OLIMEX/SOM204/SOM204-EVB/SOM204-EVB_Rev_C2.pdf

+

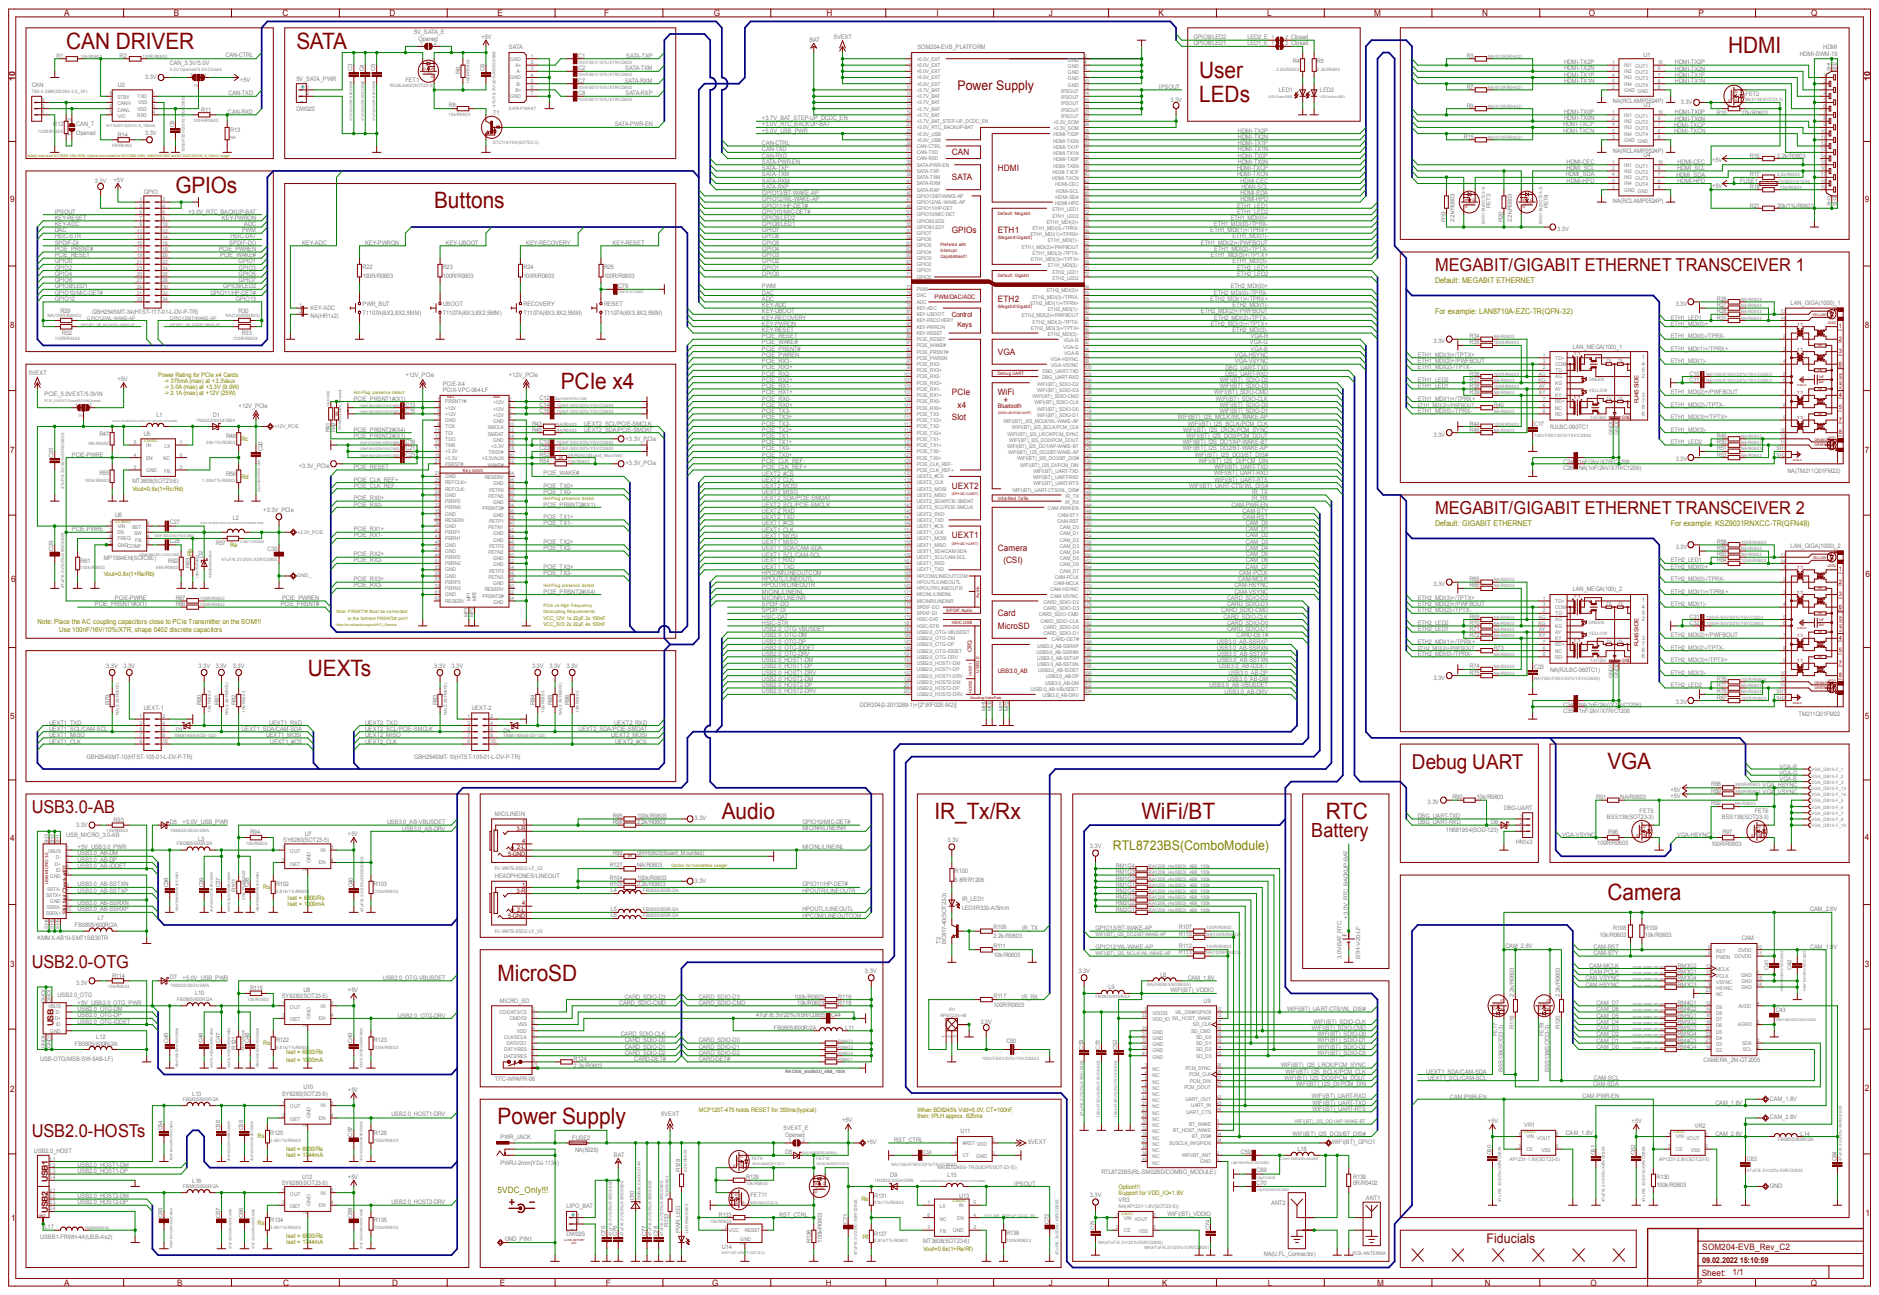
[picture p1: page 1]

Initially was used: MCP2551-I/SN(SO8). Options were added for MCP2562-E/SN, SN65HVD230D and SIT1042T/3(SOIC-8_150mil) usage!

SATA-PWR-EN 35
SATA-TXM 39 SATA-TXP 37

SATA-RXM 41
SATA-RXP 43
GPIO0 71 GPIO1 69 GPIO2 67 GPIO3 65 GPIO4 63 GPIO5 61 GPIO6 59 GPIO7 57 GPIO8/LED1 55 GPIO9/LED2 53 GPIO10/MIC-DET 51 GPIO11/HP-DET 49 GPIO12/WL-WAKE-AP 47 GPIO13/BT-WAKE-AP 45

MEGABIT/GIGABIT ETHERNET TRANSCEIVER 1

For example: LAN8710A-EZC-TR(QFN-32)

WIFI(BT)_I2S_MCLK/WL-WAKE-AP

WIFI(BT)_I2S_DO2/BT-WAKE-AP

Power Rating for PCIe x4 Cards:
-> 375mA (max) at +3.3Vaux
-> 3.0A (max) at +3.3V (9.9W)
-> 2.1A (max) at +12V (25W)

Hot-Plug presence detect

(SDIO+I2S/PCM+UART)
WIFI(BT)_I2S_MCLK/WL-WAKE-AP 116
WIFI(BT)_I2S_BCLK/PCM_CLK 118

WIFI(BT)_I2S_BCLK/PCM_CLK
WIFI(BT)_I2S_LRCK/PCM_SYNC
WIFI(BT)_I2S_DO0/PCM_DOUT

WIFI(BT)_I2S_DO0/PCM_DOUT 122
WIFI(BT)_I2S_DO1/AP-WAKE-BT 124
WIFI(BT)_I2S_DO2/BT-WAKE-AP 126
WIFI(BT)_I2S_DO3/BT_DIS# 128

WIFI(BT)_I2S_DO1/AP-WAKE-BT
WIFI(BT)_I2S_DO3/BT_DIS#
WIFI(BT)_I2S_DI/PCM_DIN
WIFI(BT)_UART-TXD
WIFI(BT)_UART-RXD

UEXT2_RXD 145 UEXT2_SCL/PCIE-SMCLK 143 UEXT2_SDA/PCIE-SMDAT 141

Infra-Red Tx/Rx

MEGABIT/GIGABIT ETHERNET TRANSCEIVER 2

UEXT1_RXD 161 UEXT1_SCL/CAM-SCL 159 UEXT1_SDA/CAM-SDA 157

CAM_D6 162
CAM_D7 164
CAM-HSYNC 170 CAM-MCLK 168 CAM-PCLK 166

PCIE_PRSNT2#(X4)

Note: PRSNT1# Must be connected
to the farthest PRSNT2# pin!!!

SPDIF-DI 177 SPDIF-DO 175

Note: Place the AC coupling capacitors close to PCIe Transmitter on the SOM!!!

Use 100nF/16V/10%/X7R, shape 0402 discrete capacitors

https://en.wikipedia.org/wiki/PCI_Express
UEXTs

Op tion for handsfree usage!

GPIO13/BT-WAKE-AP
GPIO12/WL-WAKE-AP

USB-OTG(MSB-SW-5AB-LF)

MCP120T-475 holds RESET for 350ms(typical)
