OLIMEX/SOM204/A20-SOM204/A20-SOM204_Rev_C1.pdf

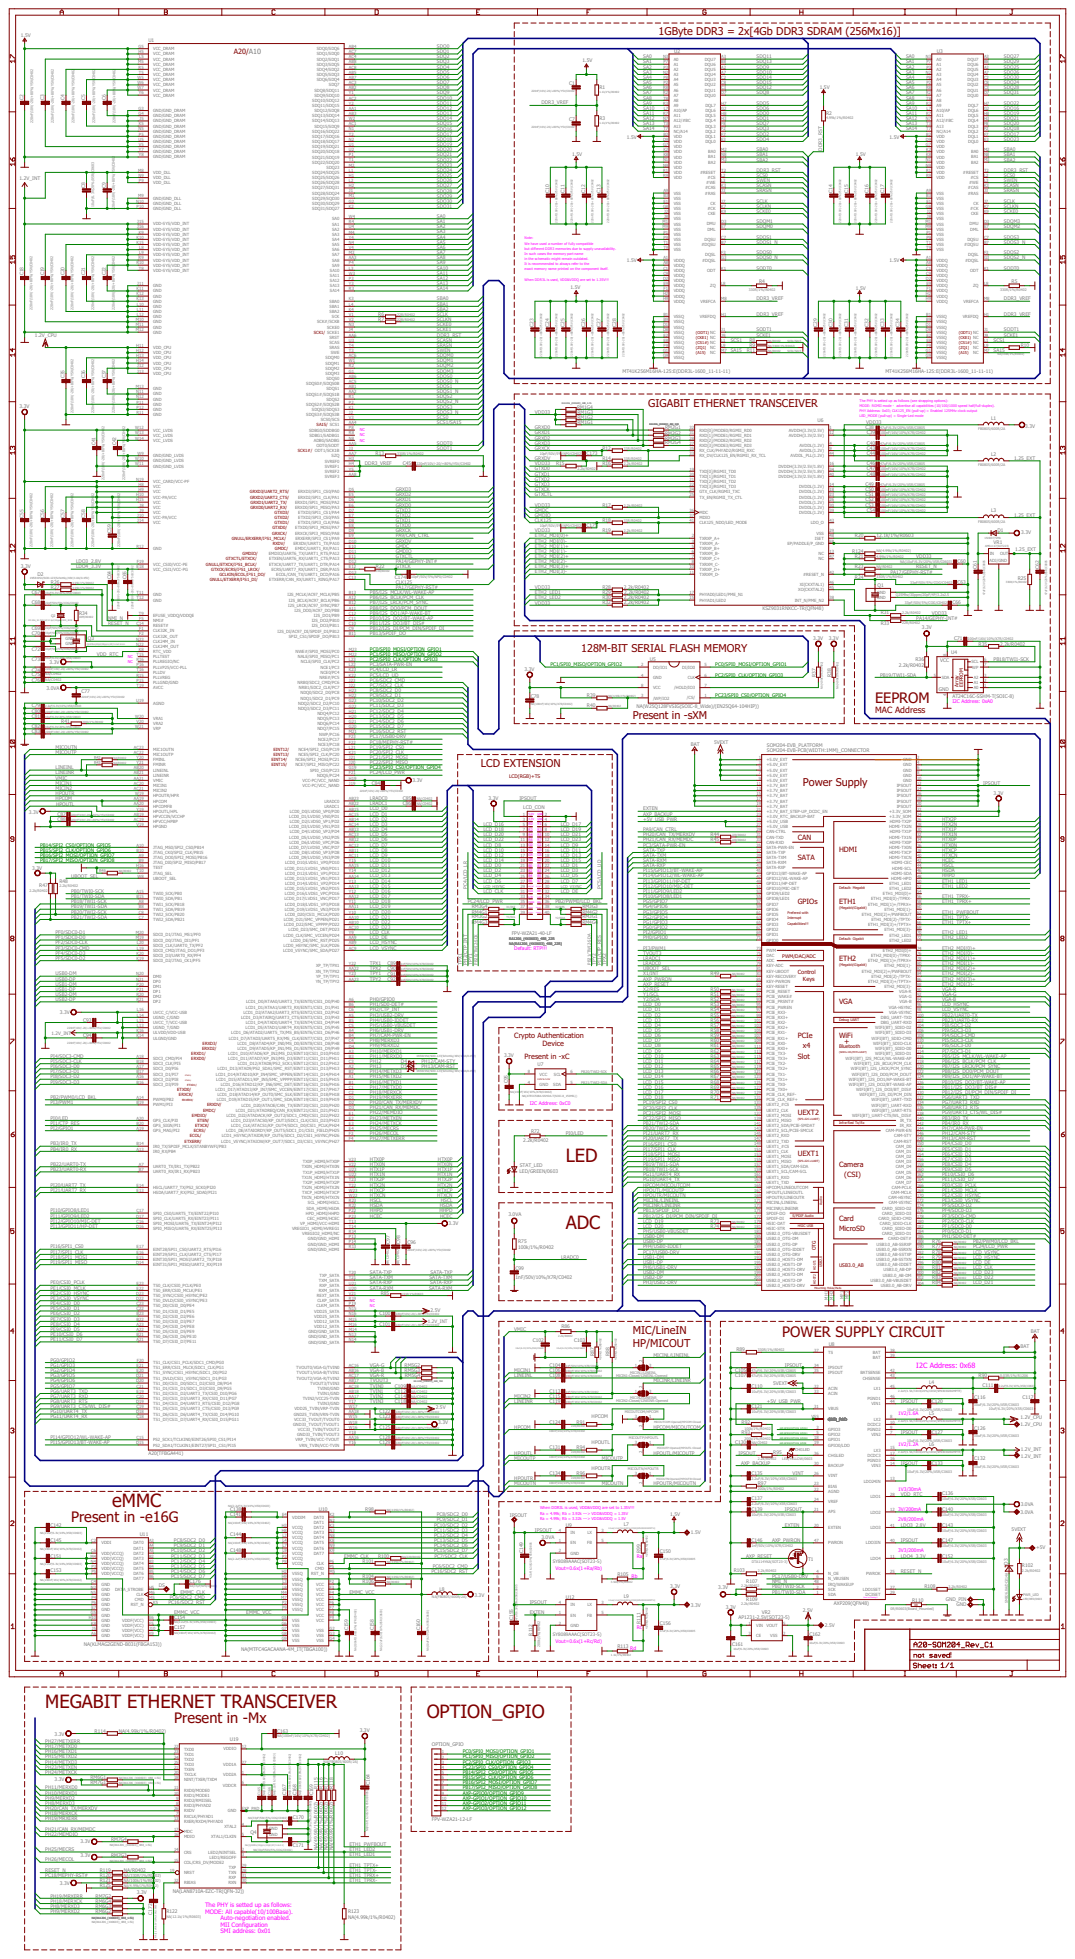
[picture p2: page 1]

74 DAC
78 KEY-ADC

1N5819S4/SOD-123(Schottky/40V/1.0A/0.45V)
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
