OLIMEX/SOM204/A20-SOM204/A20-SOM204_Rev_B1_1Gs16Me16G-MC.pdf

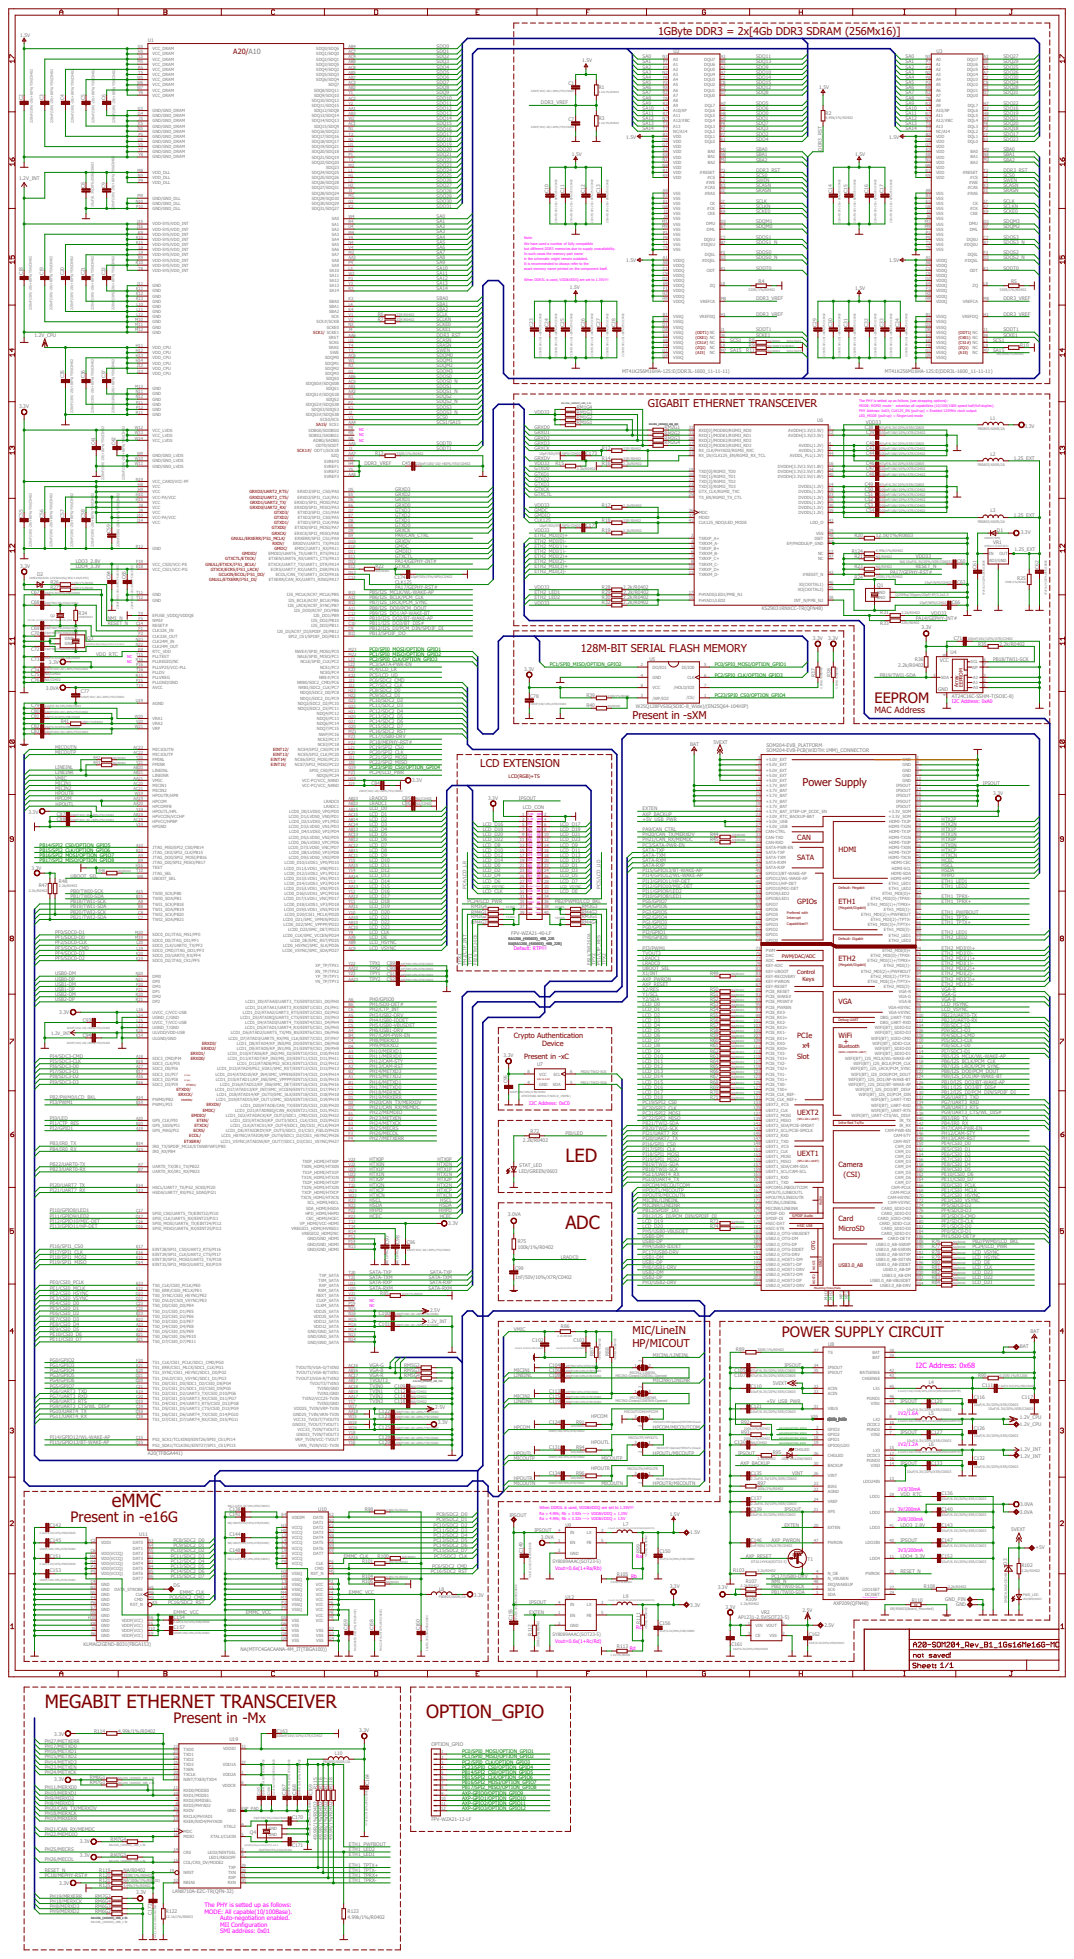
[picture p4: page 1]

74 DAC
78 KEY-ADC
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
