OLIMEX/SOM204/SOM204-EVB/SOM204-EVB_Rev_B1.pdf

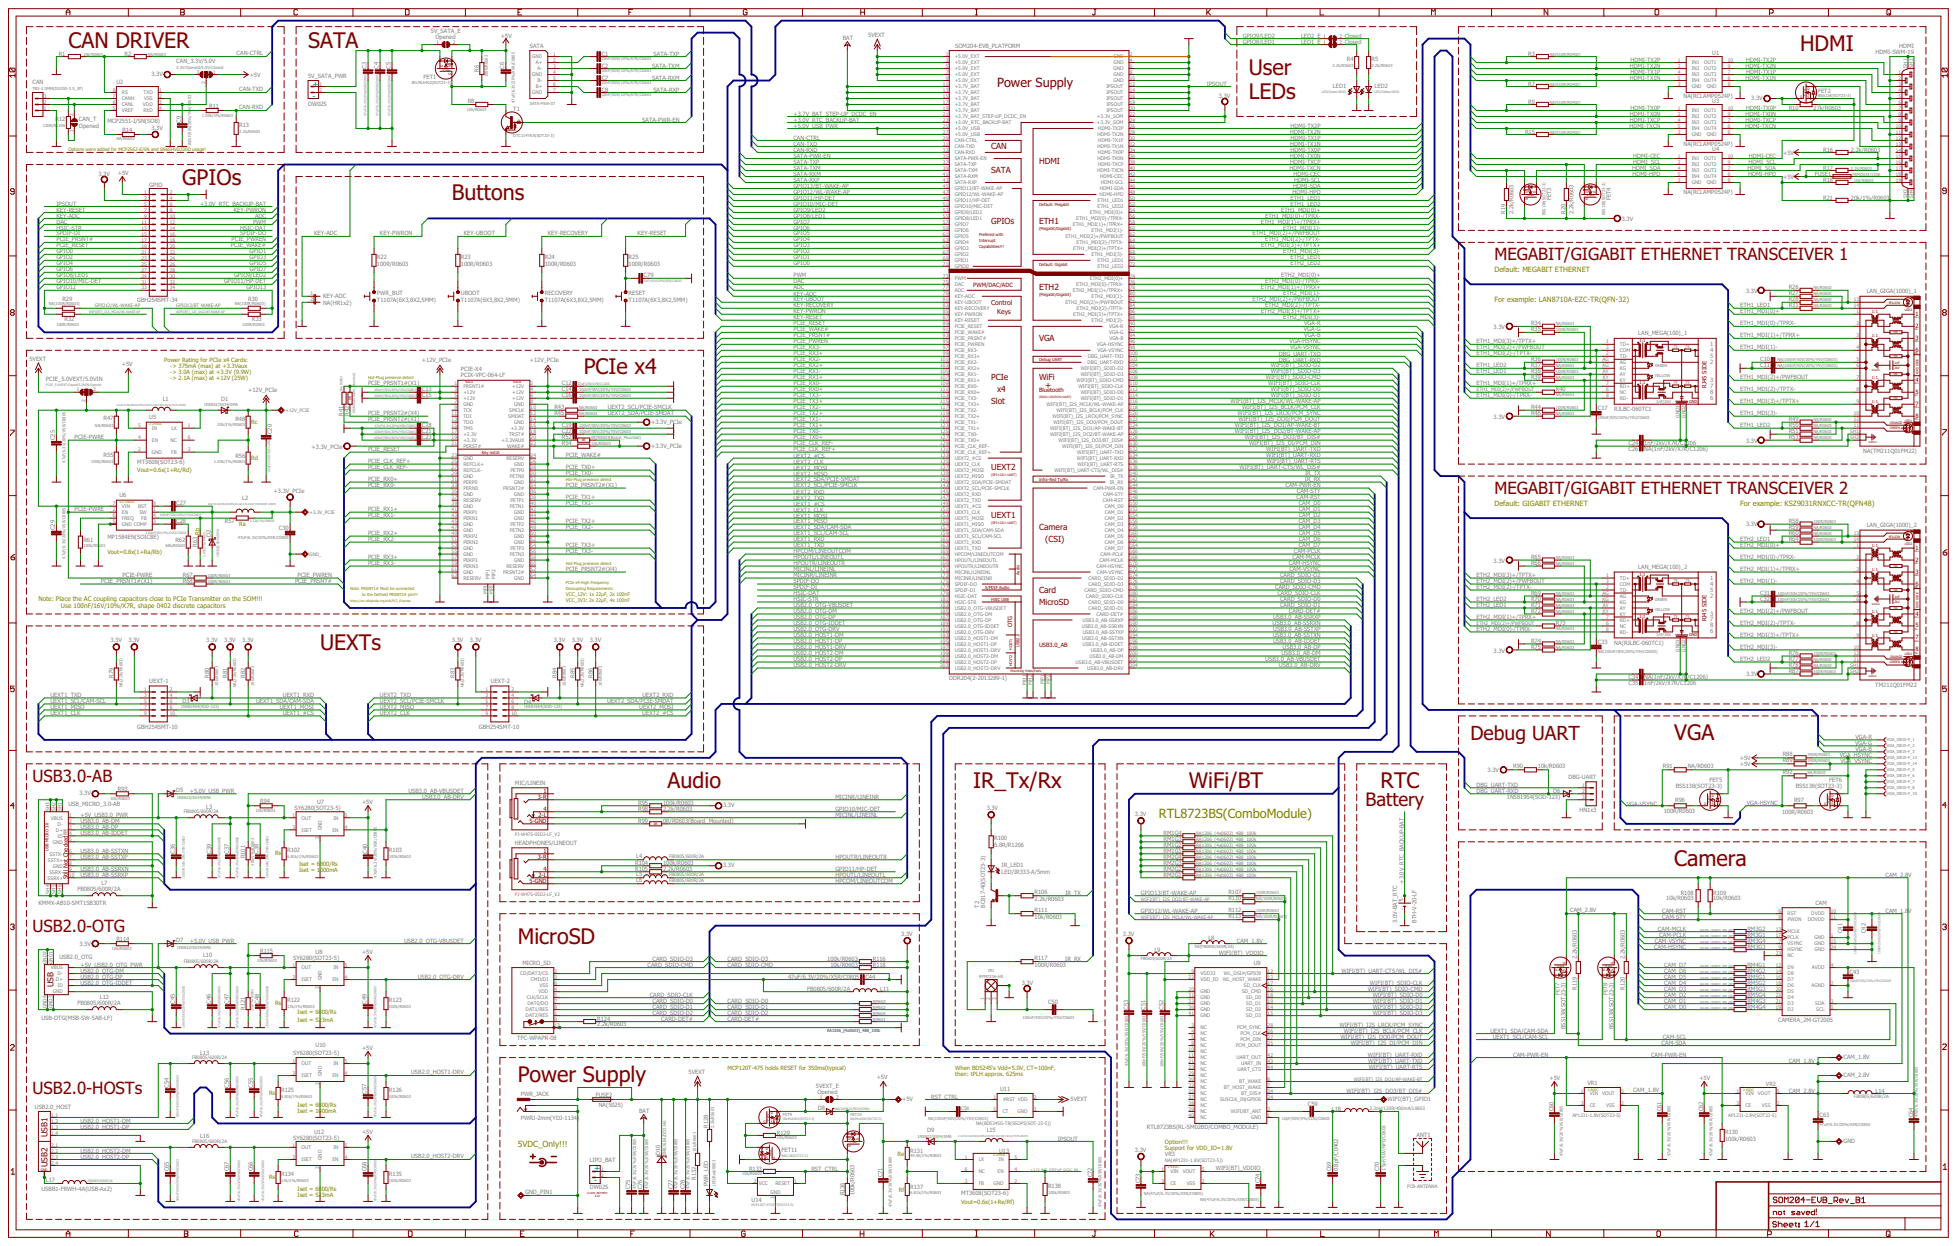
[picture p5: page 1]

Options were added for MCP2562-E/SN and SN65HVD230D usage!

Prefered with Capabilities!!! Interrupt

MEGABIT/GIGABIT ETHERNET TRANSCEIVER 1

For example: LAN8710A-EZC-TR(QFN-32)

WIFI(BT)_I2S_MCLK/WL-WAKE-AP

WIFI(BT)_I2S_DO2/BT-WAKE-AP

Hot-Plug presence detect Power Rating for PCIe x4 Cards: -> 3.0A (max) at +3.3V (9.9W)
-> 375mA (max) at +3.3Vaux

Debug UART WiFi Bluetooth +

WIFI(BT)_I2S_BCLK/PCM_CLK
WIFI(BT)_I2S_LRCK/PCM_SYNC

WIFI(BT)_I2S_DO0/PCM_DOUT
WIFI(BT)_I2S_DO1/AP-WAKE-BT
WIFI(BT)_I2S_DO3/BT_DIS#
WIFI(BT)_I2S_DI/PCM_DIN

ETH1_LED2

Infra-Red Tx/Rx

MEGABIT/GIGABIT ETHERNET TRANSCEIVER 2

Hot-Plug presence detect
PCIE_PRSNT2#(X4)

Note: PRSNT1# Must be connected
to the farthest PRSNT2# pin!!! https://en.wikipedia.org/wiki/PCI_Express

PCIe x4 High Frequency VCC_12V: 1x 22µF, 2x 100nF VCC_3V3: 2x 22µF, 4x 100nF Decoupling Requirements:

S/PDIF Audio HSIC USB

Note: Place the AC coupling capacitors close to PCIe Transmitter on the SOM!!!

Use 100nF/16V/10%/X7R, shape 0402 discrete capacitors

USB MICRO 3.0 Still Not Checked!!!

GPIO13/BT-WAKE-AP

GPIO12/WL-WAKE-AP

USB-OTG(MSB-SW-5AB-LF)

CAM-SCL CAM-SDA

When BD5245's Vdd=5.0V, CT=100nF, then: tPLH approx. 625ms MCP120T-475 holds RESET for 350ms(typical)
