OLIMEX/SOM204/A20-SOM204/A20-SOM204_Rev_C_1Gs16Me16G-MC.pdf

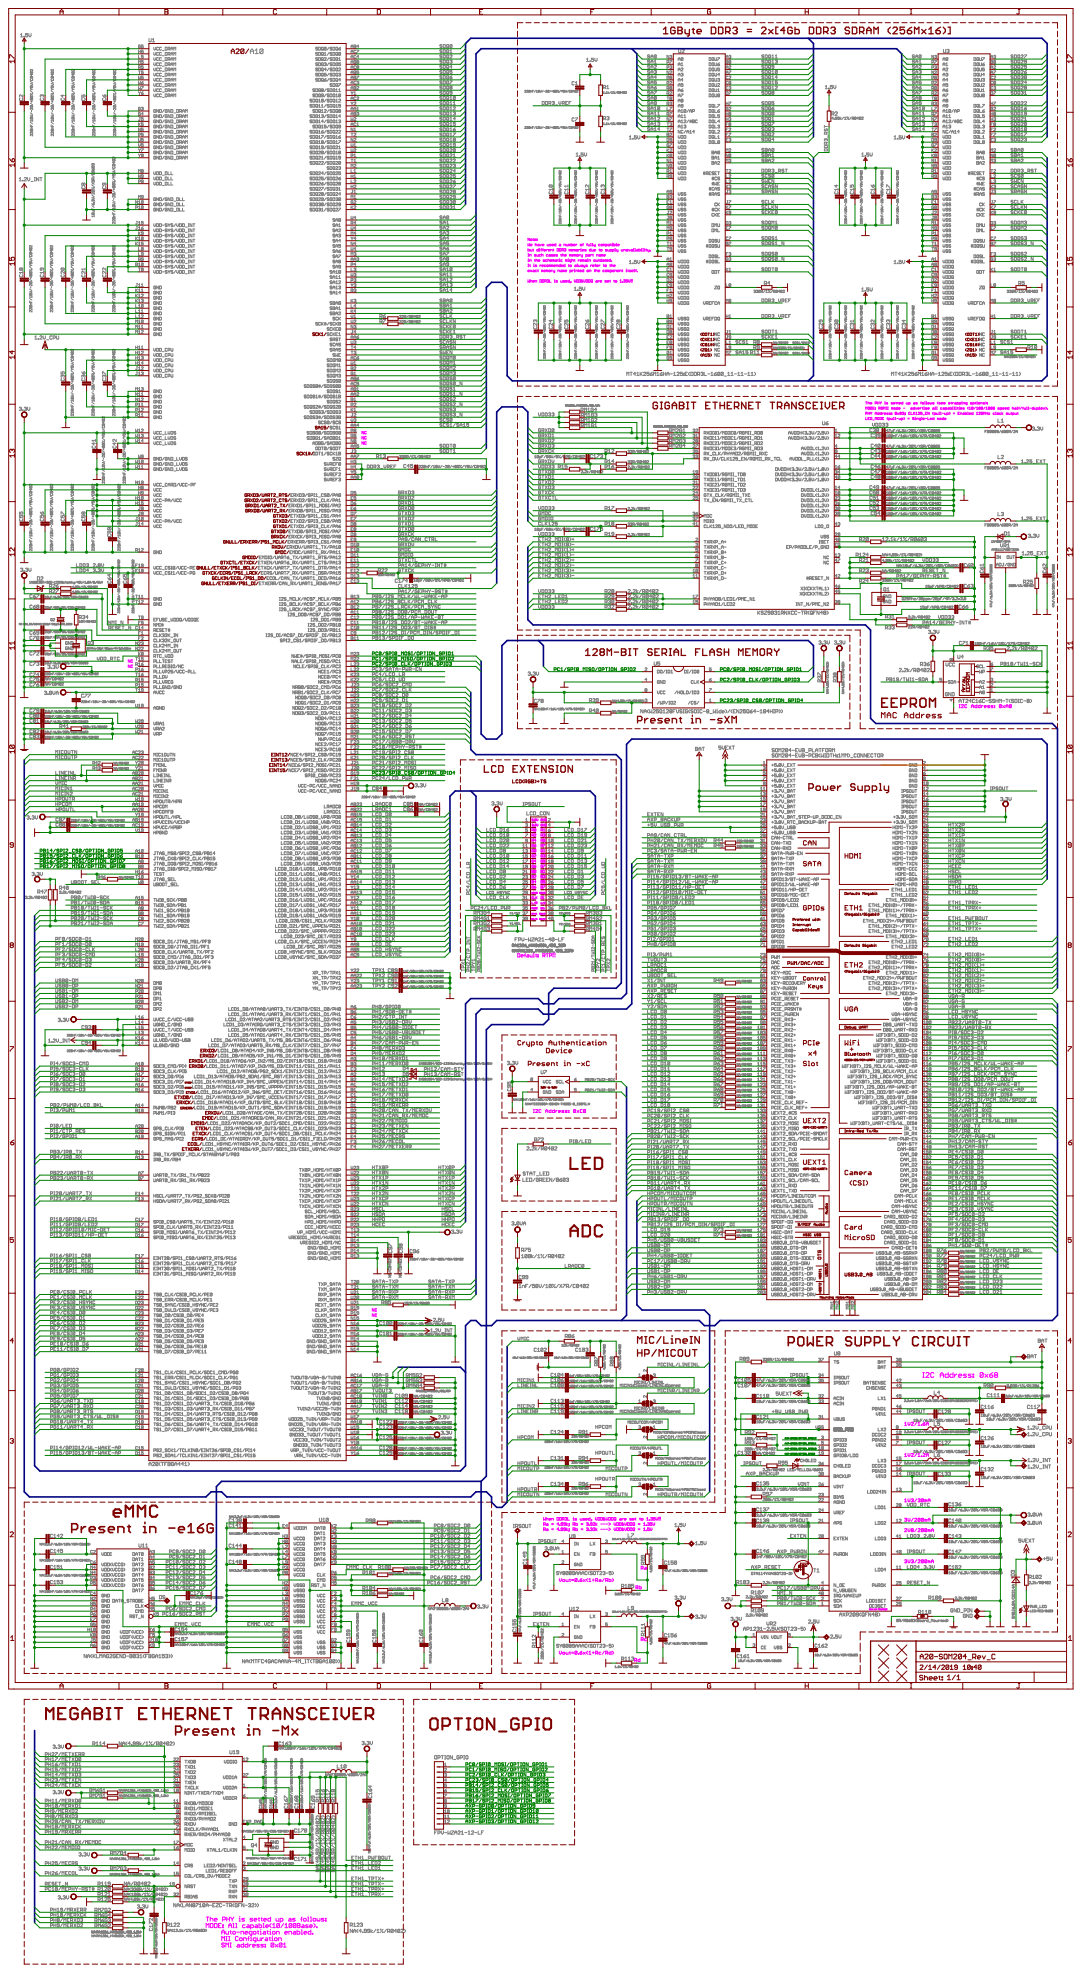
[picture p6: page 1]
