OLIMEX/SOM204/SOM204-EVB/SOM204_EVB_Platform.pdf

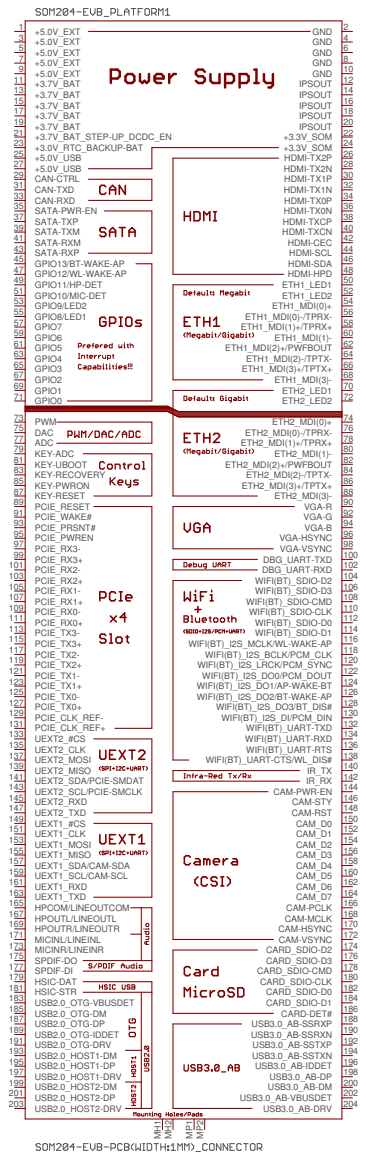
[picture p7: page 1]
