OLIMEX/SOM204/SOM204-EVB/SOM204-EVB_Rev_B.pdf

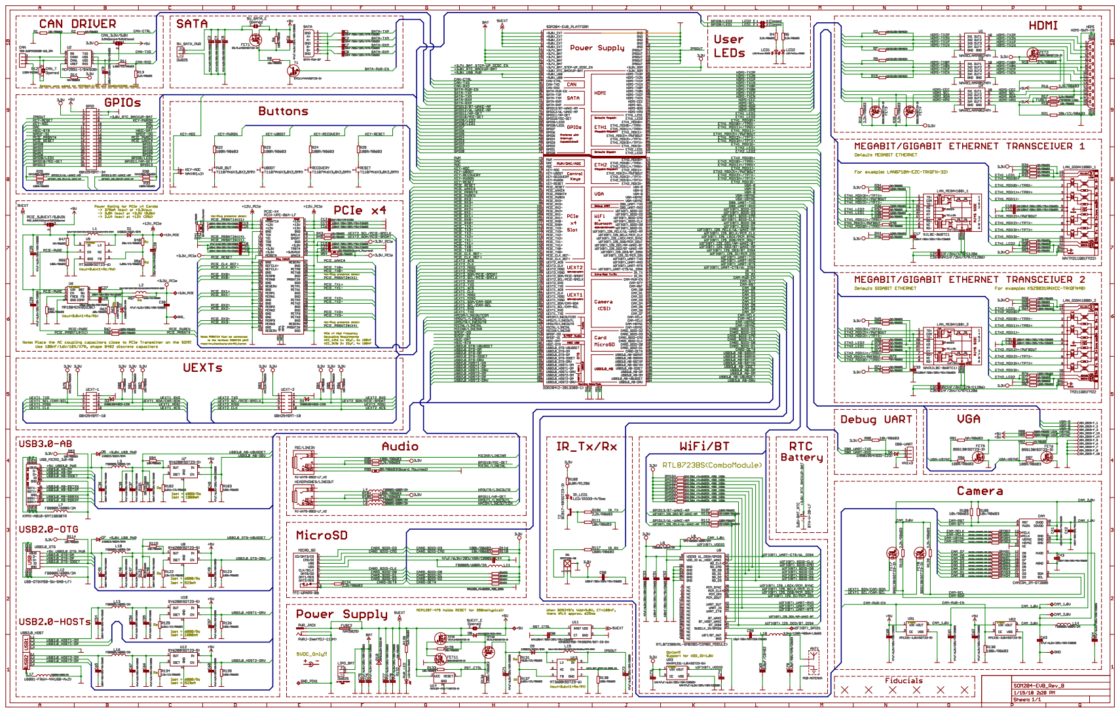
[picture p8: page 1]
