OLIMEX/SOM204/A20-SOM204/A20-SOM204_Rev_B_1Gs16Me16G-MC.pdf

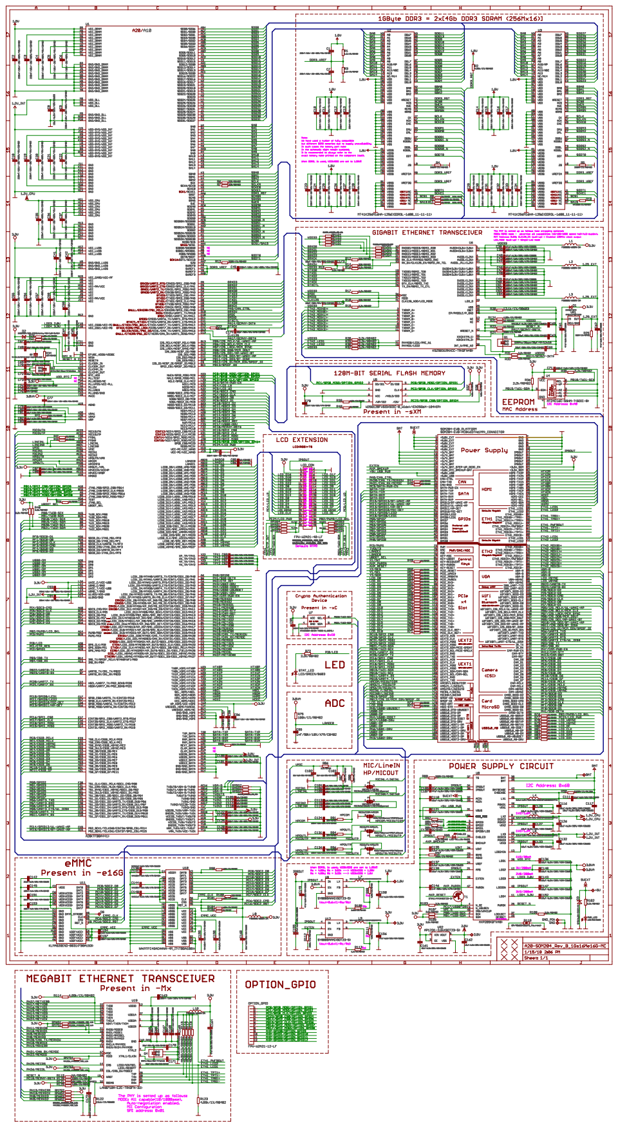
[picture p9: page 1]
