OLIMEX/SOM204/(commit log)

2018-01-16 upload SOM204-EVB files and A20-SOM204 schematic
    [SOM204-EVB_Rev_B.brd, SOM204-EVB_Rev_B.sch]
2018-01-16 upload SOM204-EVB platform
    [SOM204_EVB_Platform.sch]
2018-07-12 update
    added b1 sources
    [SOM204-EVB_Rev_B1.brd, SOM204-EVB_Rev_B1.sch]
2018-07-17 Update
    KiCAD connector footprint and symbol of A20 added
2022-02-11 Update
    New revisions and updated changelog
    [SOM204-EVB_Rev_C.brd, SOM204-EVB_Rev_C.sch, SOM204-EVB_Rev_C2.brd, SOM204-EVB_Rev_C2.sch]
